vaa1234/nixie-clock-z573m/README.md

Nixie Clock on z573m tubes, hv5222 and raspberry pi.
