vaa1234/nixie-clock-z573m/kicad/nixie socket.jpg

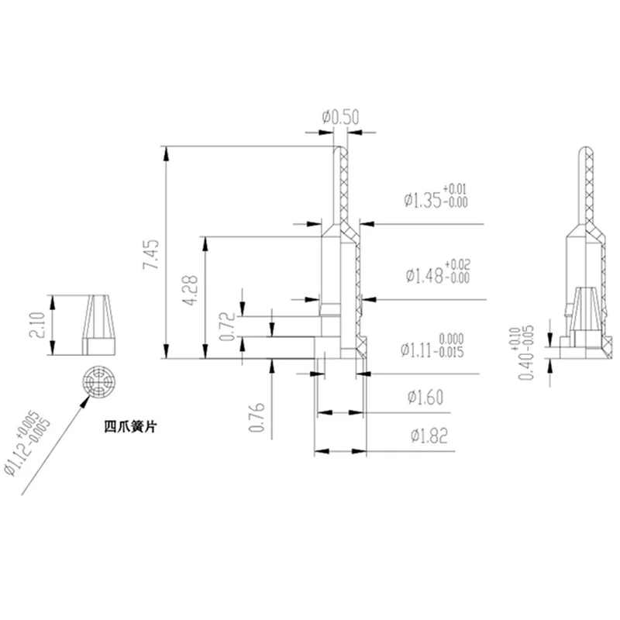
kicad/nixie socket.jpg
