vaa1234/nixie-clock-z573m/kicad/BOM.ods

Id | Designator | Footprint | Quantity | Designation | Supplier and ref
1 | R10,R9,R12,R13,R8,R11 | R_1206_3216Metric_Pad1.30x1.75mm_HandSolder | 6 | 15K
2 | V5,V1,V4,V2,V3,V6 | Z573M_SMD | 6 | Z573M
3 | C13,C12,C3,C11,C5,C4,C10,C9,C1 | C_0402_1005Metric_Pad0.74x0.62mm_HandSolder | 9 | 0.1uF
4 | C18,C19,C22,C21,C20 | C_0201_0603Metric_Pad0.64x0.40mm_HandSolder | 5 | 1uF
5 | IC1,IC2 | PQFP-44_10x10mm_P0.8mm | 2 | HV5222
6 | C7 | CP_Elec_8x10.5 | 1 | 220uF/25V
7 | U6 | RP2040-Tiny_SMD | 1 | RP2040 Tiny
8 | J1 | USB_C_Receptacle_GCT_USB4105-xx-A_16P_TopMnt_Horizontal | 1 | USB_C_Receptacle_USB2.0_16P
9 | R16 | R_0603_1608Metric_Pad0.98x0.95mm_HandSolder | 1 | 220R
10 | R15,R14 | R_0201_0603Metric_Pad0.64x0.40mm_HandSolder | 2 | 10K
11 | U3 | SO-8_3.9x4.9mm_P1.27mm | 1 | MAX1771xSA
12 | U4 | tps61088_module | 1 | tps61088 dcdc module
13 | U1 | SOIC-16W_7.5x10.3mm_P1.27mm | 1 | DS3231SN
14 | BT1 | BatteryHolder_Keystone_3000_1x12mm | 1 | CR1220
15 | C6 | C_1206_3216Metric_Pad1.33x1.80mm_HandSolder | 1 | 100nF/250V
16 | R4 | R_0603_1608Metric_Pad0.98x0.95mm_HandSolder | 1 | 4.7K
17 | F1 | Fuse_1812_4532Metric_Pad1.30x3.40mm_HandSolder | 1 | MF-MSMF110-2
18 | D3 | D_SOD-323 | 1 | PESD5V0S1BA
19 | R3 | R_0603_1608Metric_Pad0.98x0.95mm_HandSolder | 1 | 100K
20 | U5 | DIP-4_W7.62mm_Socket | 1 | TLP627
21 | D1 | D_SMB_Handsoldering | 1 | ES2F
22 | R6 | R_0603_1608Metric_Pad0.98x0.95mm_HandSolder | 1 | 10K
23 | R2,R1 | R_0402_1005Metric_Pad0.72x0.64mm_HandSolder | 2 | 5.1K
24 | RV1 | Potentiometer_Bourns_3224W_Vertical | 1 | 5K
25 | U2 | SOIC-16W_5.3x10.2mm_P1.27mm | 1 | CD4504B
26 | SW1 | SW_Tactile_SPST_Angled_PTS645Vx83-2LFS | 1 | select digit
27 | Q1 | TO-252-2 | 1 | IRF740
28 | R7 | R_0603_1608Metric_Pad0.98x0.95mm_HandSolder | 1 | 1.5M
29 | L1 | L_12x12mm_H8mm | 1 | 100uH
30 | C2 | C_0805_2012Metric_Pad1.18x1.45mm_HandSolder | 1 | 10uF
31 | SW2 | SW_Tactile_SPST_Angled_PTS645Vx83-2LFS | 1 | increase number
32 | R5 | R_2010_5025Metric_Pad1.40x2.65mm_HandSolder | 1 | 0R050 0.5W
33 | C8 | CP_Elec_8x10 | 1 | 4.7uF/250V
