vaa1234/nixie-clock-z573m/kicad/nixie-clock-z573m.kicad_pcb

## KiCad design kicad/nixie-clock-z573m.kicad_pcb (2025-09-12)

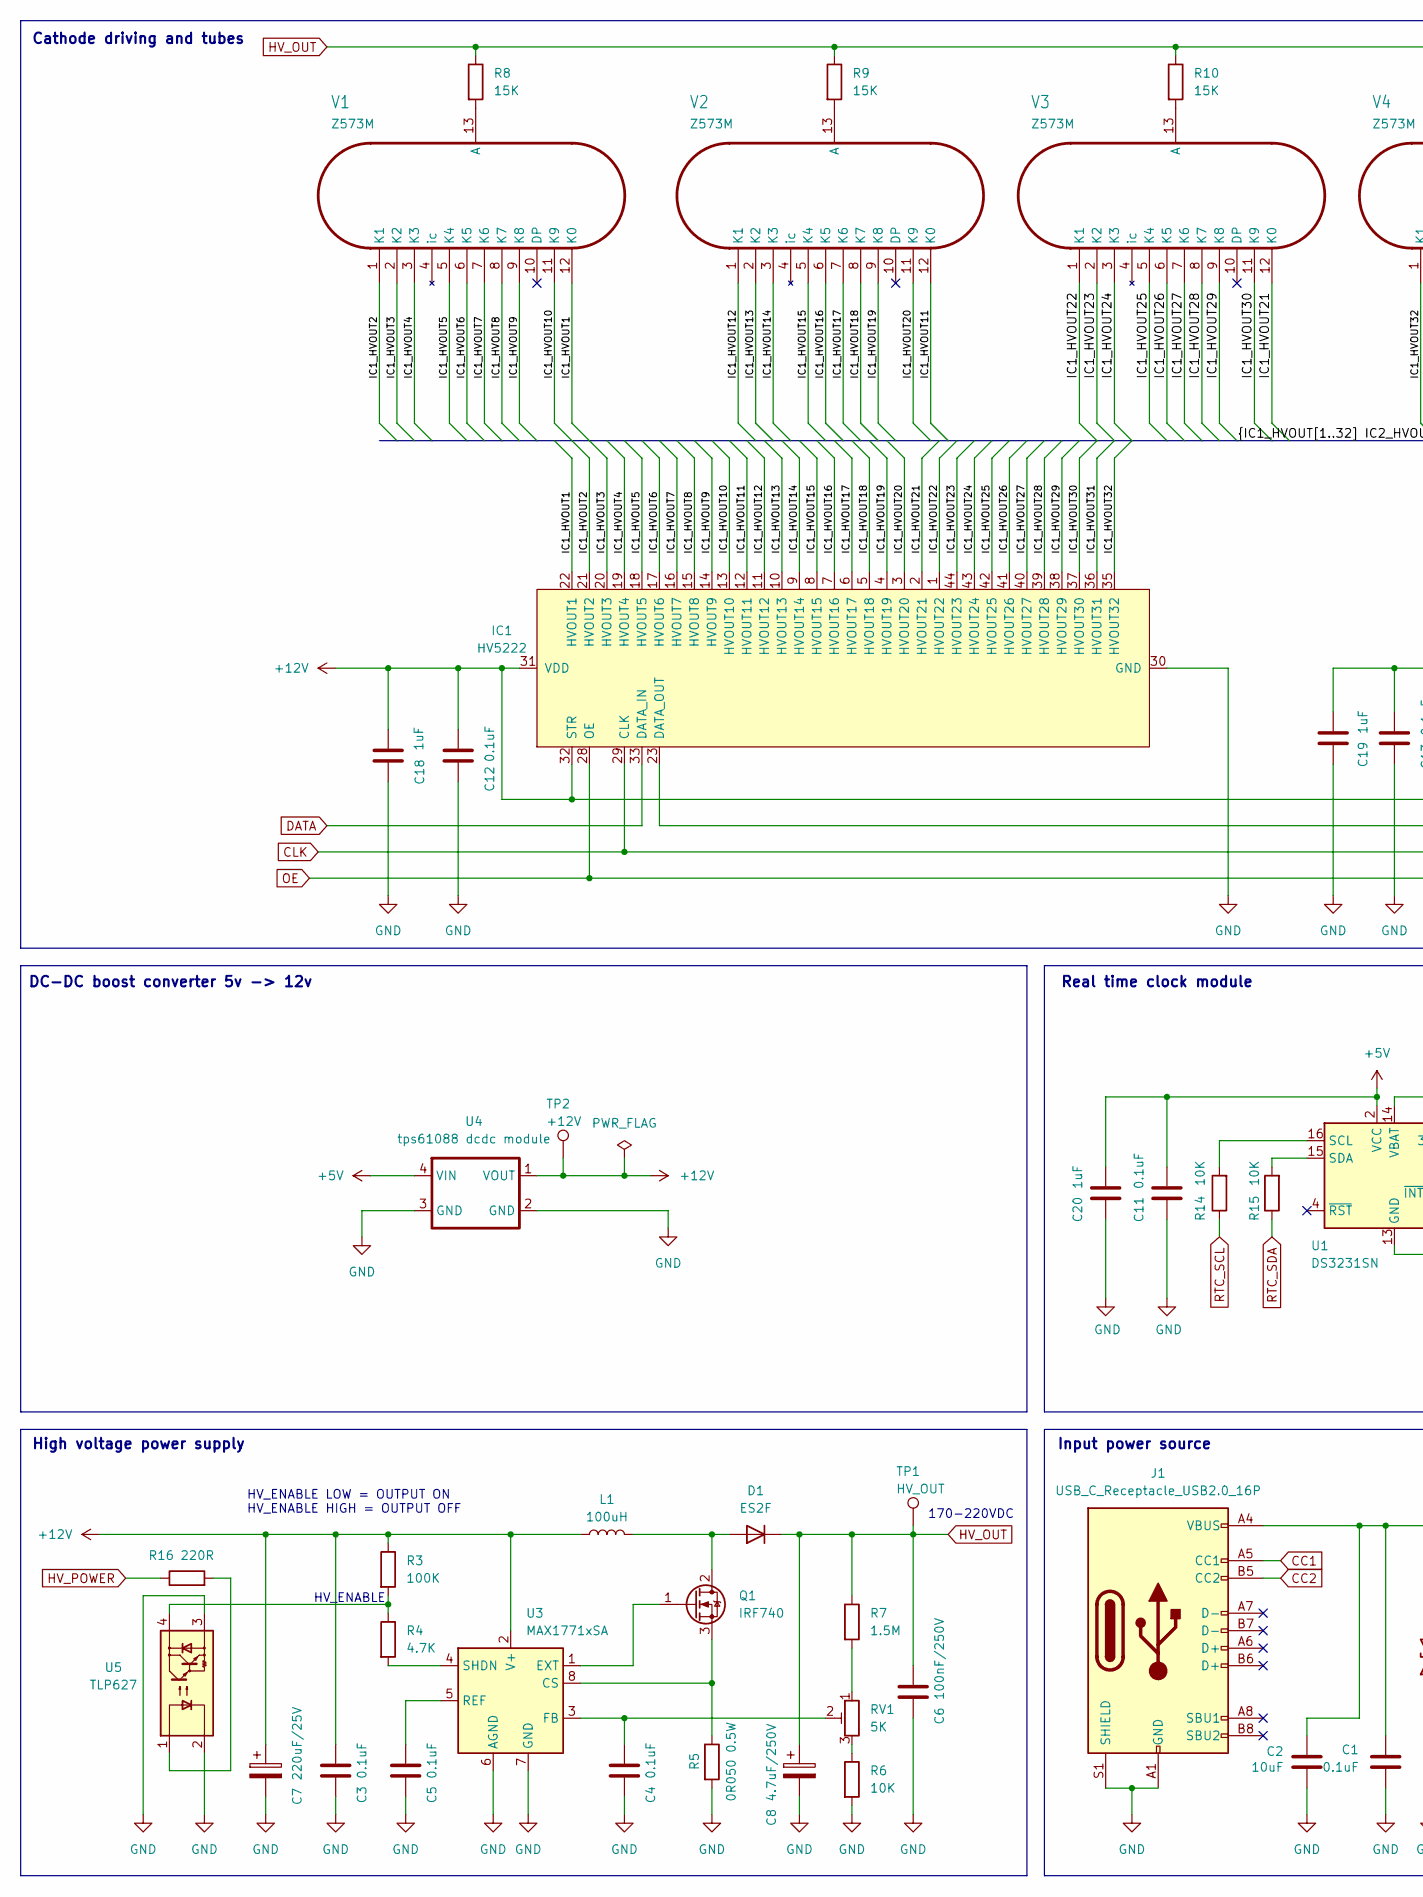
[picture p2: schematic nixie-clock-z573m.kicad_sch, Nixie clock z573m, part in row 1, column 1]

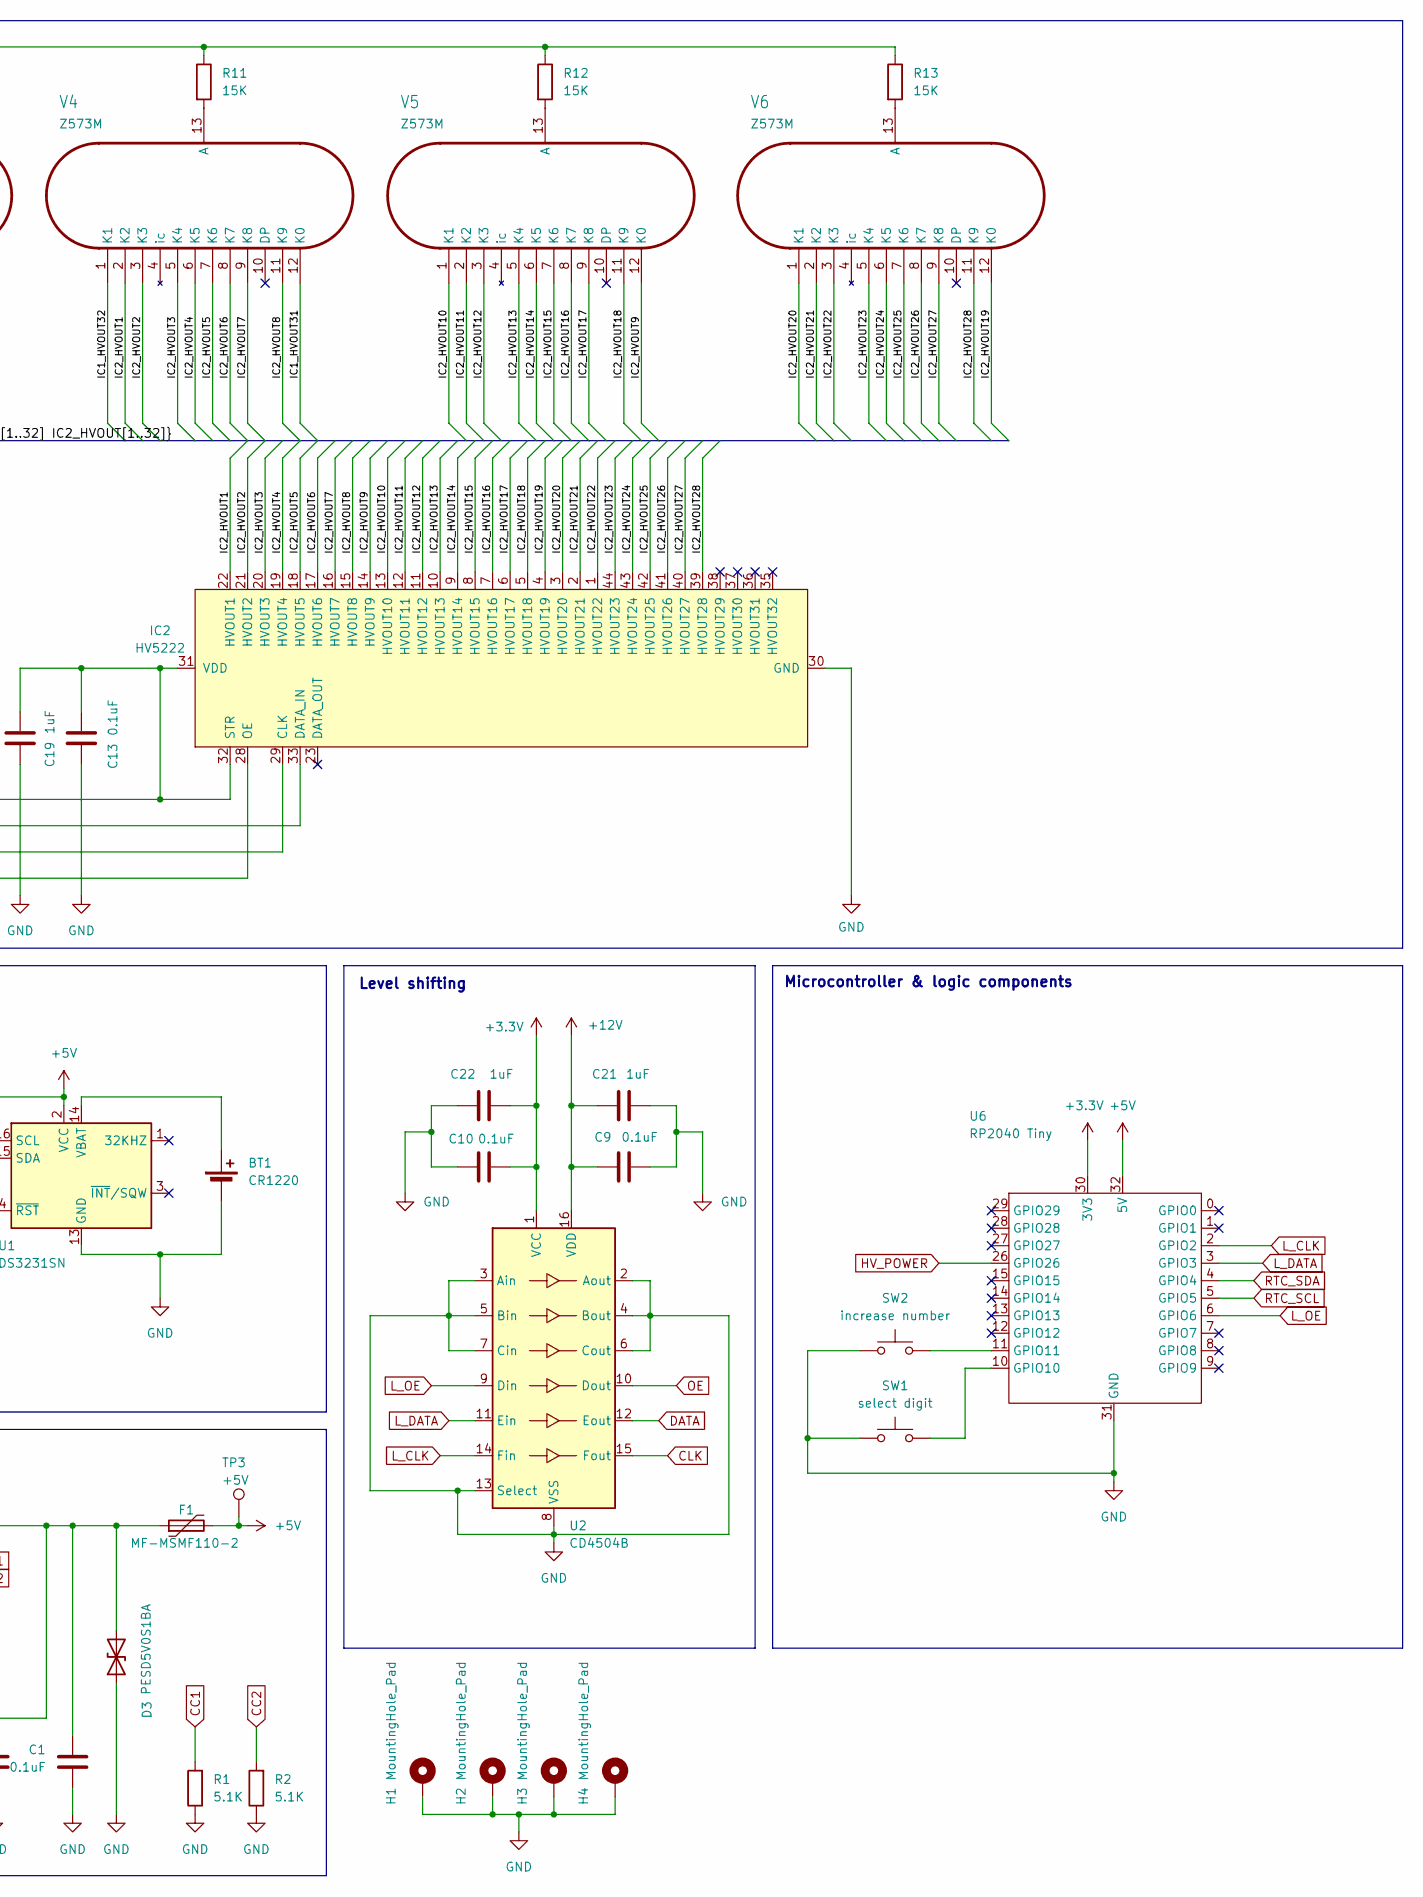
[picture p3: schematic nixie-clock-z573m.kicad_sch, Nixie clock z573m, part in row 1, column 2]

Parts:
BT1: CR1220; BatteryHolder_Keystone_3000_1x12mm
C1, C3, C4, C5, C9, C10, C11, C12, C13: 0.1uF; C_0402_1005Metric_Pad0.74x0.62mm_HandSolder
C2: 10uF; C_0805_2012Metric_Pad1.18x1.45mm_HandSolder
C6: 100nF/250V; C_1206_3216Metric_Pad1.33x1.80mm_HandSolder
C7: 220uF/25V; CP_Elec_8x10.5
C8: 4.7uF/250V; CP_Elec_8x10
C18, C19, C20, C21, C22: 1uF; C_0201_0603Metric_Pad0.64x0.40mm_HandSolder
D1: ES2F; D_SMB_Handsoldering
D3: PESD5V0S1BA; D_SOD-323
F1: MF-MSMF110-2; Fuse_1812_4532Metric_Pad1.30x3.40mm_HandSolder
H1, H2, H3, H4: MountingHole_Pad; MountingHole_3mm_Pad_Via
IC1, IC2: HV5222; PQFP-44_10x10mm_P0.8mm
J1: USB_C_Receptacle_USB2.0_16P; USB_C_Receptacle_GCT_USB4105-xx-A_16P_TopMnt_Horizontal
L1: 100uH; L_12x12mm_H8mm
Q1: IRF740; TO-252-2
R1, R2: 5.1K; R_0402_1005Metric_Pad0.72x0.64mm_HandSolder
R3: 100K; R_0603_1608Metric_Pad0.98x0.95mm_HandSolder
R4: 4.7K; R_0603_1608Metric_Pad0.98x0.95mm_HandSolder
R5: 0R050 0.5W; R_2010_5025Metric_Pad1.40x2.65mm_HandSolder
R6: 10K; R_0603_1608Metric_Pad0.98x0.95mm_HandSolder
R7: 1.5M; R_0603_1608Metric_Pad0.98x0.95mm_HandSolder
R8, R9, R10, R11, R12, R13: 15K; R_1206_3216Metric_Pad1.30x1.75mm_HandSolder
R14, R15: 10K; R_0201_0603Metric_Pad0.64x0.40mm_HandSolder
R16: 220R; R_0603_1608Metric_Pad0.98x0.95mm_HandSolder
RV1: 5K; Potentiometer_Bourns_3224W_Vertical
SW1: select digit; SW_Tactile_SPST_Angled_PTS645Vx83-2LFS
SW2: increase number; SW_Tactile_SPST_Angled_PTS645Vx83-2LFS
TP1: HV_OUT; TestPoint_Pad_D1.0mm
TP2: +12V; TestPoint_Pad_D1.0mm
TP3: +5V; TestPoint_Pad_D1.0mm
U1: DS3231SN; SOIC-16W_7.5x10.3mm_P1.27mm
U2: CD4504B; SOIC-16W_5.3x10.2mm_P1.27mm
U3: MAX1771xSA; SO-8_3.9x4.9mm_P1.27mm
U4: tps61088 dcdc module; tps61088_module
U5: TLP627; DIP-4_W7.62mm_Socket
U6: RP2040 Tiny; RP2040-Tiny_SMD
V1, V2, V3, V4, V5, V6: Z573M; Z573M_SMD

Connections:
+3.3V: C10.2, C22.2, U2.1 (VCC), U6.30 (3V3)
+5V: C11.1, C20.1, F1.2, TP3.1, U1.2 (VCC), U4.4 (VIN), U6.32 (5V)
+12V: C3.1, C7.1, C9.1, C12.1, C13.1, C18.1, C19.1, C21.1, IC1.31 (VDD), IC1.32 (STR), IC2.31 (VDD), IC2.32 (STR), L1.1, R3.1, TP2.1, U2.16 (VDD), U3.2 (V+), U4.1 (VOUT)
/IC1_HVOUT1: IC1.22 (HVOUT1), V1.12 (K0)
/IC1_HVOUT2: IC1.21 (HVOUT2), V1.1 (K1)
/IC1_HVOUT3: IC1.20 (HVOUT3), V1.2 (K2)
/IC1_HVOUT4: IC1.19 (HVOUT4), V1.3 (K3)
/IC1_HVOUT5: IC1.18 (HVOUT5), V1.5 (K4)
/IC1_HVOUT6: IC1.17 (HVOUT6), V1.6 (K5)
/IC1_HVOUT7: IC1.16 (HVOUT7), V1.7 (K6)
/IC1_HVOUT8: IC1.15 (HVOUT8), V1.8 (K7)
/IC1_HVOUT9: IC1.14 (HVOUT9), V1.9 (K8)
/IC1_HVOUT10: IC1.13 (HVOUT10), V1.11 (K9)
/IC1_HVOUT11: IC1.12 (HVOUT11), V2.12 (K0)
/IC1_HVOUT12: IC1.11 (HVOUT12), V2.1 (K1)
/IC1_HVOUT13: IC1.10 (HVOUT13), V2.2 (K2)
/IC1_HVOUT14: IC1.9 (HVOUT14), V2.3 (K3)
/IC1_HVOUT15: IC1.8 (HVOUT15), V2.5 (K4)
/IC1_HVOUT16: IC1.7 (HVOUT16), V2.6 (K5)
/IC1_HVOUT17: IC1.6 (HVOUT17), V2.7 (K6)
/IC1_HVOUT18: IC1.5 (HVOUT18), V2.8 (K7)
/IC1_HVOUT19: IC1.4 (HVOUT19), V2.9 (K8)
/IC1_HVOUT20: IC1.3 (HVOUT20), V2.11 (K9)
/IC1_HVOUT21: IC1.2 (HVOUT21), V3.12 (K0)
/IC1_HVOUT22: IC1.1 (HVOUT22), V3.1 (K1)
/IC1_HVOUT23: IC1.44 (HVOUT23), V3.2 (K2)
/IC1_HVOUT24: IC1.43 (HVOUT24), V3.3 (K3)
/IC1_HVOUT25: IC1.42 (HVOUT25), V3.5 (K4)
/IC1_HVOUT26: IC1.41 (HVOUT26), V3.6 (K5)
/IC1_HVOUT27: IC1.40 (HVOUT27), V3.7 (K6)
/IC1_HVOUT28: IC1.39 (HVOUT28), V3.8 (K7)
/IC1_HVOUT29: IC1.38 (HVOUT29), V3.9 (K8)
/IC1_HVOUT30: IC1.37 (HVOUT30), V3.11 (K9)
/IC1_HVOUT31: IC1.36 (HVOUT31), V4.12 (K0)
/IC1_HVOUT32: IC1.35 (HVOUT32), V4.1 (K1)
/IC2_HVOUT1: IC2.22 (HVOUT1), V4.2 (K2)
/IC2_HVOUT2: IC2.21 (HVOUT2), V4.3 (K3)
/IC2_HVOUT3: IC2.20 (HVOUT3), V4.5 (K4)
/IC2_HVOUT4: IC2.19 (HVOUT4), V4.6 (K5)
/IC2_HVOUT5: IC2.18 (HVOUT5), V4.7 (K6)
/IC2_HVOUT6: IC2.17 (HVOUT6), V4.8 (K7)
/IC2_HVOUT7: IC2.16 (HVOUT7), V4.9 (K8)
/IC2_HVOUT8: IC2.15 (HVOUT8), V4.11 (K9)
/IC2_HVOUT9: IC2.14 (HVOUT9), V5.12 (K0)
/IC2_HVOUT10: IC2.13 (HVOUT10), V5.1 (K1)
/IC2_HVOUT11: IC2.12 (HVOUT11), V5.2 (K2)
/IC2_HVOUT12: IC2.11 (HVOUT12), V5.3 (K3)
/IC2_HVOUT13: IC2.10 (HVOUT13), V5.5 (K4)
/IC2_HVOUT14: IC2.9 (HVOUT14), V5.6 (K5)
/IC2_HVOUT15: IC2.8 (HVOUT15), V5.7 (K6)
/IC2_HVOUT16: IC2.7 (HVOUT16), V5.8 (K7)
/IC2_HVOUT17: IC2.6 (HVOUT17), V5.9 (K8)
/IC2_HVOUT18: IC2.5 (HVOUT18), V5.11 (K9)
/IC2_HVOUT19: IC2.4 (HVOUT19), V6.12 (K0)
/IC2_HVOUT20: IC2.3 (HVOUT20), V6.1 (K1)
/IC2_HVOUT21: IC2.2 (HVOUT21), V6.2 (K2)
/IC2_HVOUT22: IC2.1 (HVOUT22), V6.3 (K3)
/IC2_HVOUT23: IC2.44 (HVOUT23), V6.5 (K4)
/IC2_HVOUT24: IC2.43 (HVOUT24), V6.6 (K5)
/IC2_HVOUT25: IC2.42 (HVOUT25), V6.7 (K6)
/IC2_HVOUT26: IC2.41 (HVOUT26), V6.8 (K7)
/IC2_HVOUT27: IC2.40 (HVOUT27), V6.9 (K8)
/IC2_HVOUT28: IC2.39 (HVOUT28), V6.11 (K9)
CC1: J1.A5 (CC1), R1.2
CC2: J1.B5 (CC2), R2.2
CLK: IC1.29 (CLK), IC2.29 (CLK), U2.15 (Fout)
DATA: IC1.33 (DATA_IN), U2.12 (Eout)
GND: BT1.2 (-), C1.2, C2.1, C3.2, C4.2, C5.2, C6.2, C7.2, C8.2, C9.2, C10.1, C11.2, C12.2, C13.2, C18.2, C19.2, C20.2, C21.2, C22.1, D3.1 (A1), H1.1, H2.1, H3.1, H4.1, IC1.30 (GND), IC2.30 (GND), J1.A1 (GND), J1.A12 (GND), J1.B1 (GND), J1.B12 (GND), J1.S1 (SHIELD), R1.1, R2.1, R5.2, R6.2, SW1.1, SW2.1, U1.5 (GND), U1.6 (GND), U1.7 (GND), U1.8 (GND), U1.9 (GND), U1.10 (GND), U1.11 (GND), U1.12 (GND), U1.13 (GND), U2.2 (Aout), U2.3 (Ain), U2.4 (Bout), U2.5 (Bin), U2.6 (Cout), U2.7 (Cin), U2.8 (VSS), U2.13 (Select), U3.6 (AGND), U3.7 (GND), U4.2 (GND), U4.3 (GND), U5.2, U5.3, U6.31 (GND)
HV_OUT: C6.1, C8.1, D1.1 (K), R7.1, R8.1, R9.1, R10.1, R11.1, R12.1, R13.1, TP1.1
HV_POWER: R16.1, U6.26 (GPIO26)
L_CLK: U2.14 (Fin), U6.2 (GPIO2)
L_DATA: U2.11 (Ein), U6.3 (GPIO3)
L_OE: U2.9 (Din), U6.6 (GPIO6)
unnamed: BT1.1 (+), U1.14 (VBAT)
unnamed: D1.2 (A), L1.2, Q1.2 (D)
unnamed: C1.1, C2.2, D3.2 (A2), F1.1, J1.A4 (VBUS), J1.A9 (VBUS), J1.B4 (VBUS), J1.B9 (VBUS)
unnamed: IC1.23 (DATA_OUT), IC2.33 (DATA_IN)
unnamed: Q1.1 (G), U3.1 (EXT)
unnamed: Q1.3 (S), R5.1, U3.8 (CS)
unnamed: R3.2, R4.1, U5.4
unnamed: R6.1, RV1.3
unnamed: R7.2, RV1.1
unnamed: R16.2, U5.1
unnamed: R14.2, U1.16 (SCL)
unnamed: R15.2, U1.15 (SDA)
unnamed: C4.1, RV1.2, U3.3 (FB)
unnamed: C5.1, U3.5 (REF)
unnamed: R4.2, U3.4 (SHDN)
unnamed: SW1.2, U6.10 (GPIO10)
unnamed: SW2.2, U6.11 (GPIO11)
unnamed: R8.2, V1.13 (A)
unnamed: R9.2, V2.13 (A)
unnamed: R10.2, V3.13 (A)
unnamed: R11.2, V4.13 (A)
unnamed: R12.2, V5.13 (A)
unnamed: R13.2, V6.13 (A)
OE: IC1.28 (OE), IC2.28 (OE), U2.10 (Dout)
RTC_SCL: R14.1, U6.5 (GPIO5)
RTC_SDA: R15.1, U6.4 (GPIO4)

Notes on the sheet:
Level shifting
High voltage power supply
Real time clock module
HV_ENABLE LOW = OUTPUT ON HV_ENABLE HIGH = OUTPUT OFF
Input power source
Microcontroller & logic components
Cathode driving and tubes
170-220VDC
HV_ENABLE
DC-DC boost converter 5v -> 12v

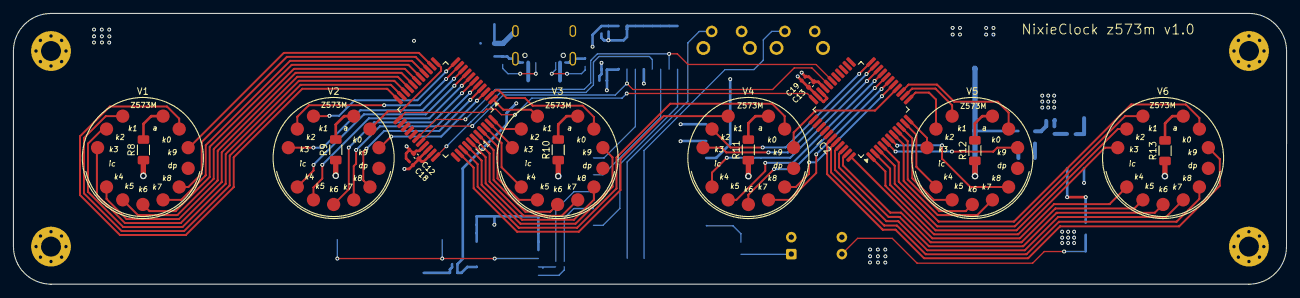
[picture p4: board nixie-clock-z573m.kicad_pcb from above]

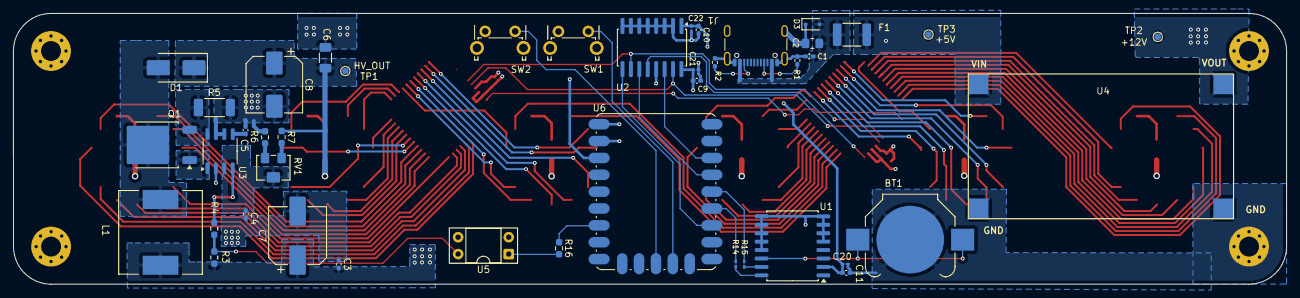
[picture p5: board nixie-clock-z573m.kicad_pcb from below]

Board: 4 copper layers, 191.8 x 40.8 mm, 65 parts (43 on the bottom side), 99 nets.
